sorell/whirling-electrons/README.md

PCB files and SW (mainly) for arduino
=====================================

Advent calendar
---------------
Pushing a button gives a random led from 4x6 matrix. Non-volatile state saving.

Bmp2arduino
-----------
Utility for converting a BMP to C code.

Infinity table
--------------
Lightshow for adressable RGB leds.

Tea timer
---------
Tea timer with I2C display and buzzer. Simple animations and a few songs, all in C.

Xmas lights
-----------
Like infinity table, different show.
