sorell/whirling-electrons/infinity-table-pcb/README.md

# PCB for the infinity-table project

Drive RGB leds with Arduino.

## Components

### Arduino Nano v2 or v3

### Barrel jack
Takes 8 ampers. Talk about oversizing.
https://www.digikey.fi/product-detail/en/cui-inc/PJ-063AH/CP-063AH-ND/2161208

## Future plans

Connect with Raspberry Pi to let the leds react with music.

### 74LVC8T245
Level shifter for future testing connection Arduino with Raspberry Pi
How to connect in [Adafruit page](https://www.adafruit.com/product/735)
