sorell/whirling-electrons/advent-calendar-rnd-sw/README.md

A simple advent calendar that randomizes one window when button is pressed. Remember displayed windows by writing state to eeprom.
