sorell/whirling-electrons/arduino-nano-breakout-1-pcb/README.md

# arduino-nano-breakout-1

A PCB design which houses an Arduino Nano, 5,5mm barrel jack, power source selection and output pin header for gpio.
