sorell/whirling-electrons/tea-timer-sw/README.md

# Tea timer

A tea timer with Arduino Nano, SSD1331 16-bit color OLED display, buzzer and two buttons.
