sorell/whirling-electrons/xmas-lights-sw/README.md

# XMAS LEDs

Wandering colors from WS2812 LED strips.
