sorell/whirling-electrons/kicad-ss-libs/FDN337N.models/ON_Semi_-_FDN337N.step

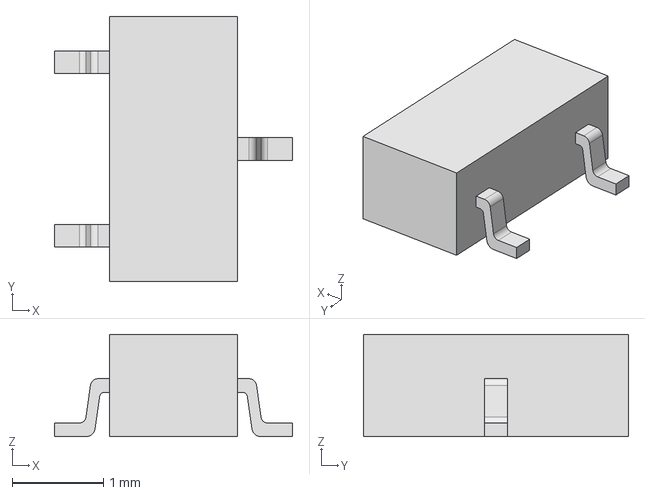
[picture p1: CAD file, 2022-10-30]
kicad-ss-libs/FDN337N.models/ON_Semi_-_FDN337N.step
2.61 x 2.90 x 1.12 mm
