sorell/whirling-electrons/advent-calendar-rnd-pcb/advent-calendar-rnd-sch.pdf

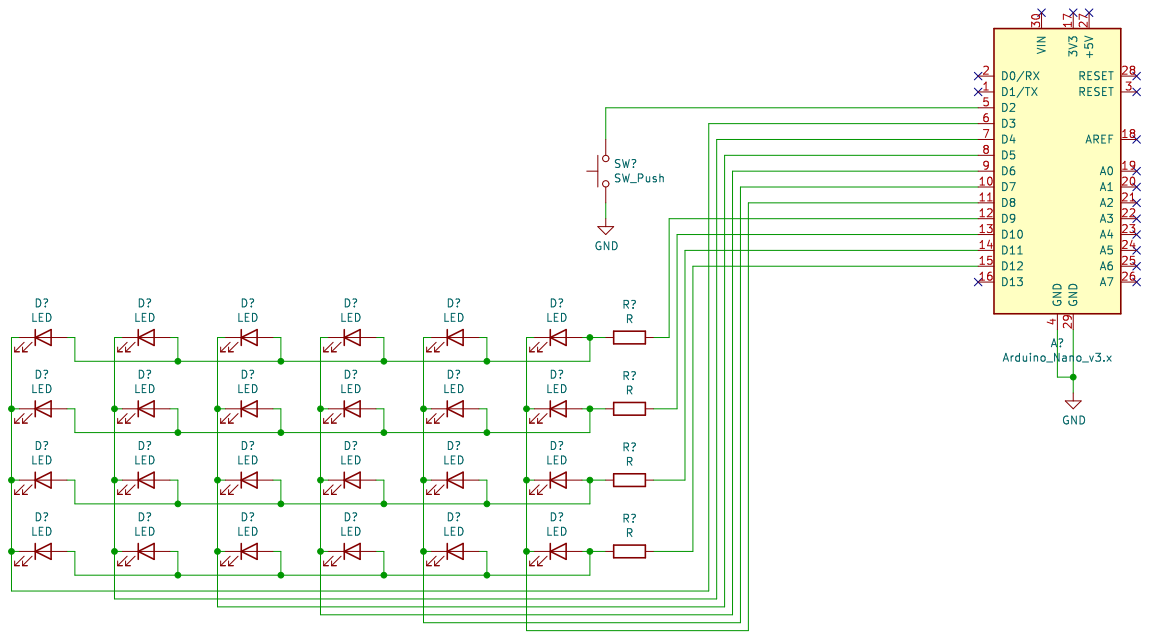
[picture p2: page 1]
