sorell/whirling-electrons/infinity-table-pcb/infinity-table-pcb.pdf

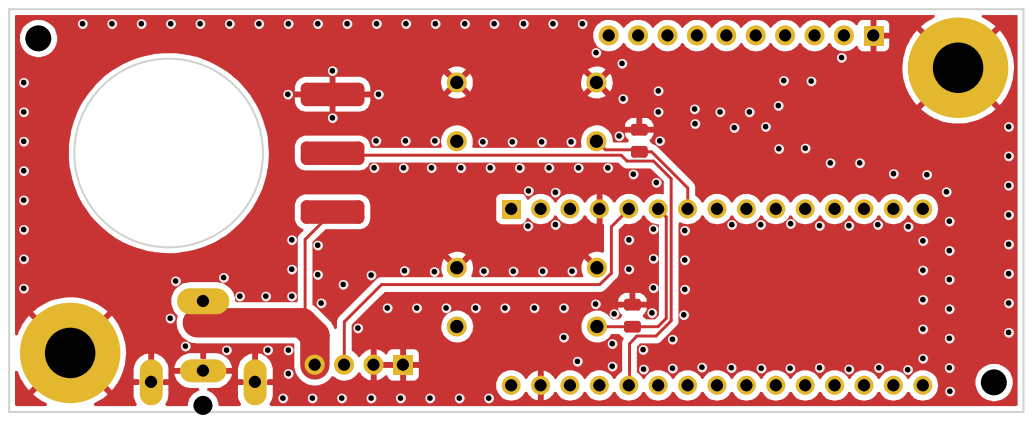
[picture p3: page 1]

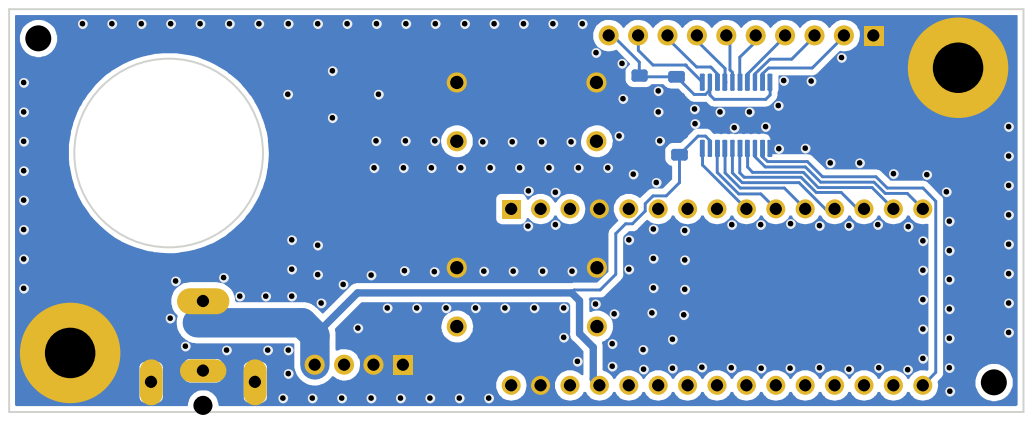
[picture p4: page 2]
