sorell/whirling-electrons/infinity-table-pcb/infinity-table-sch.pdf

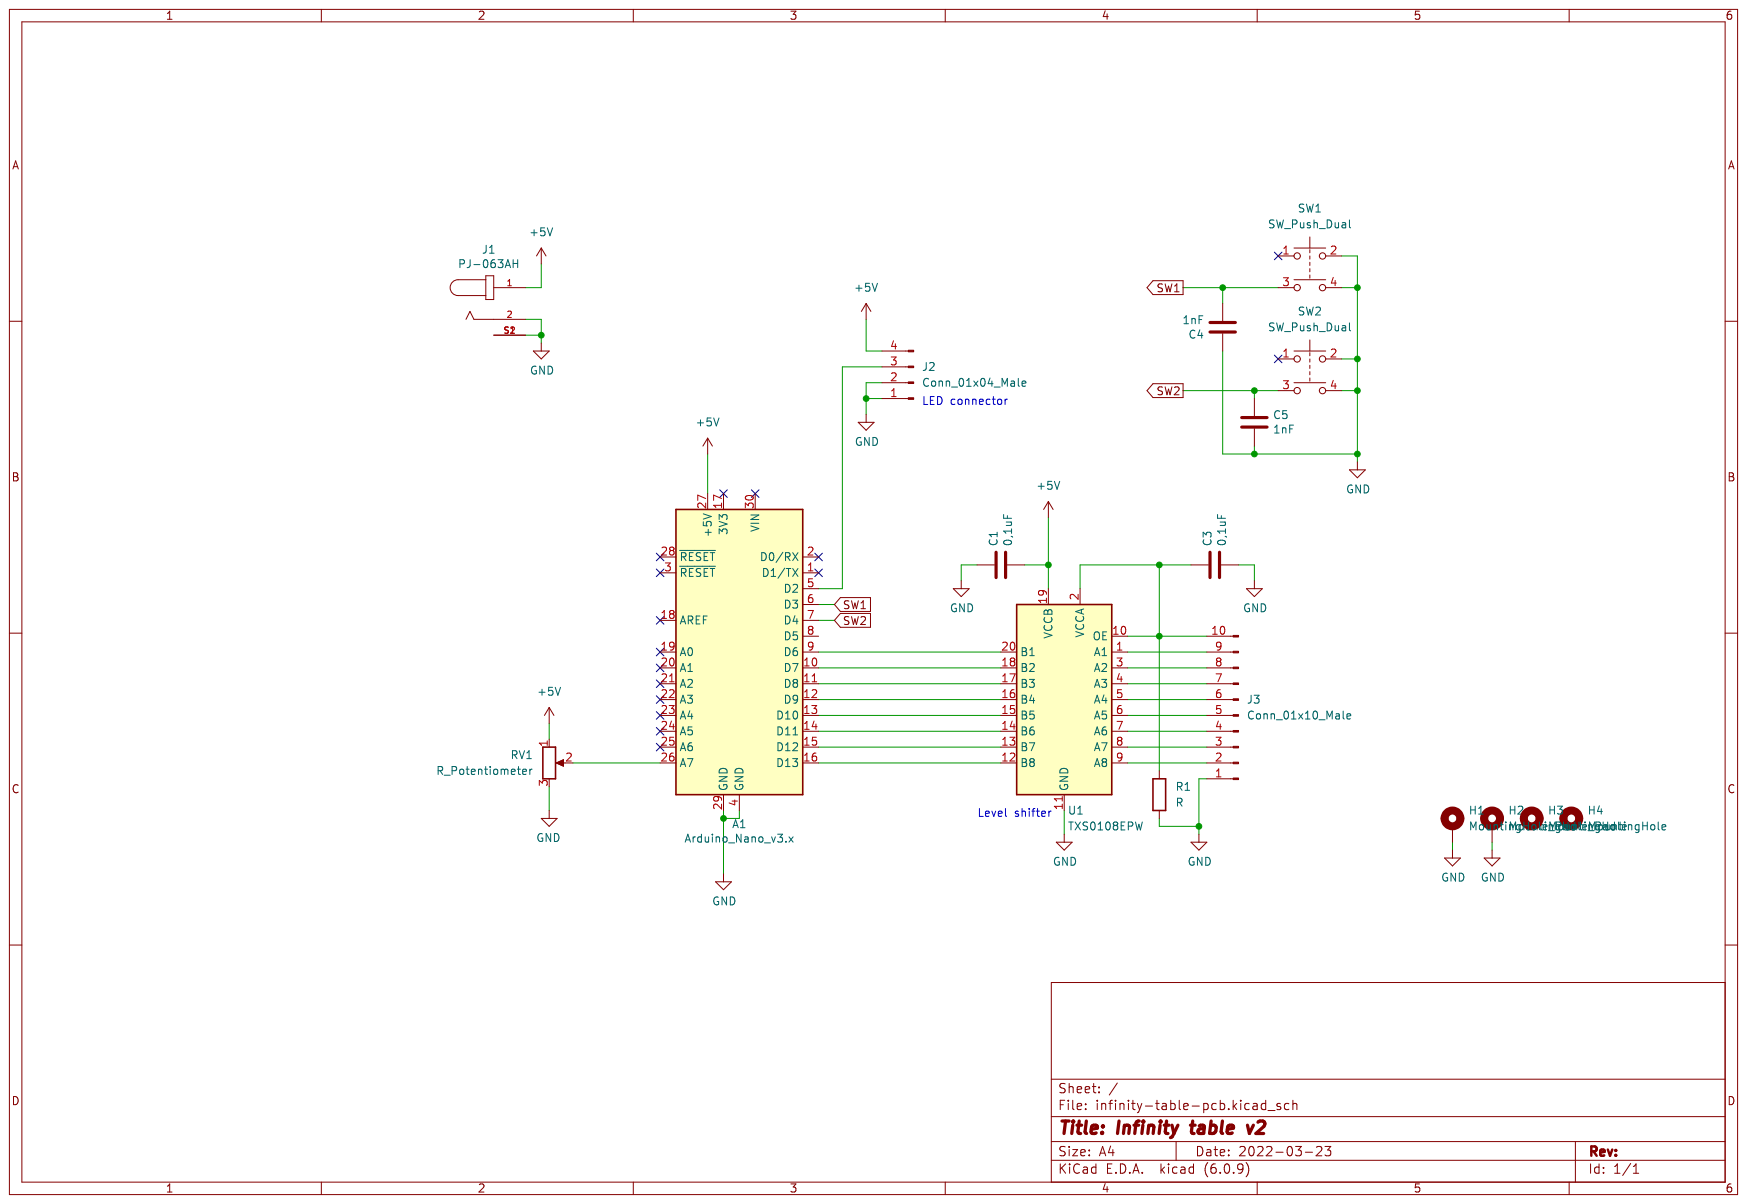
[picture p5: page 1]
