sorell/whirling-electrons/stairway-to-heaven-pcb/stairway-to-heaven-pcb.pdf

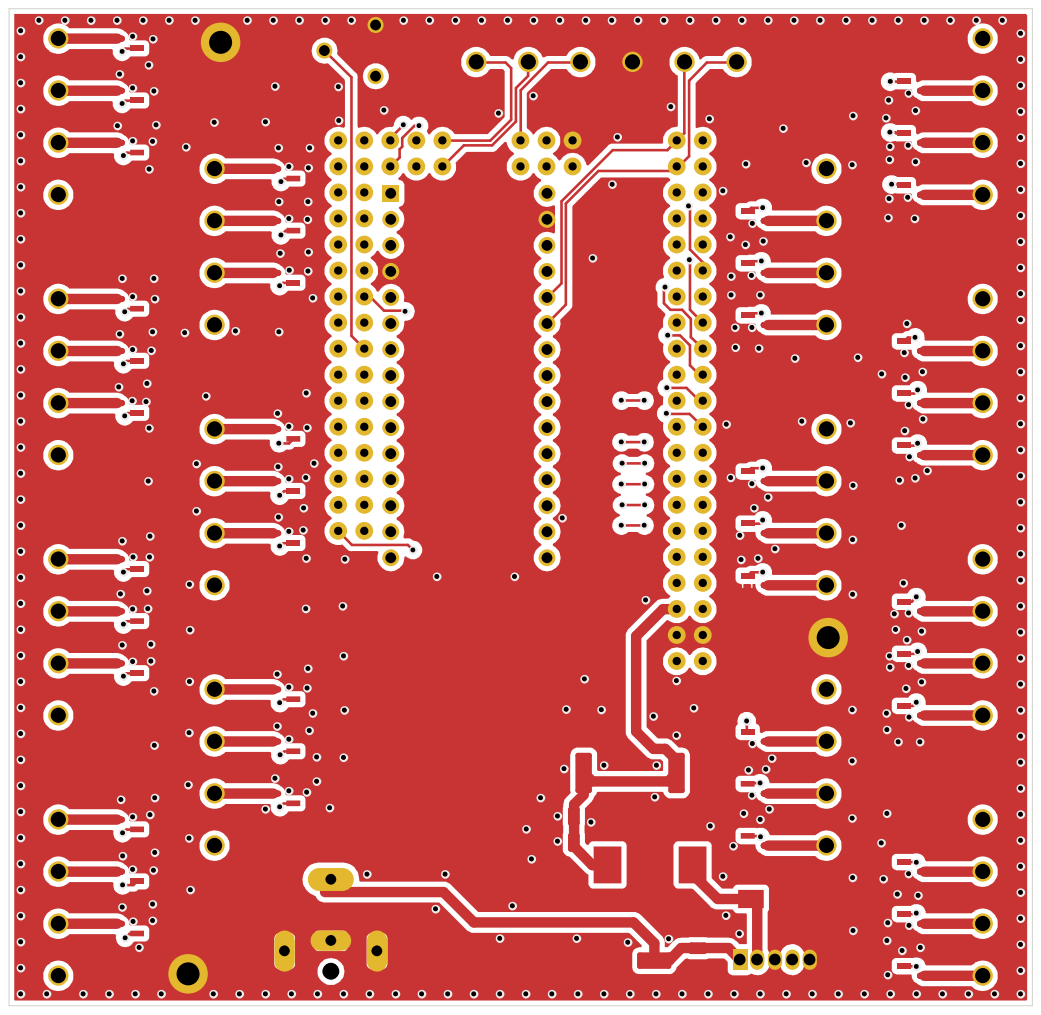
[picture p6: page 1]

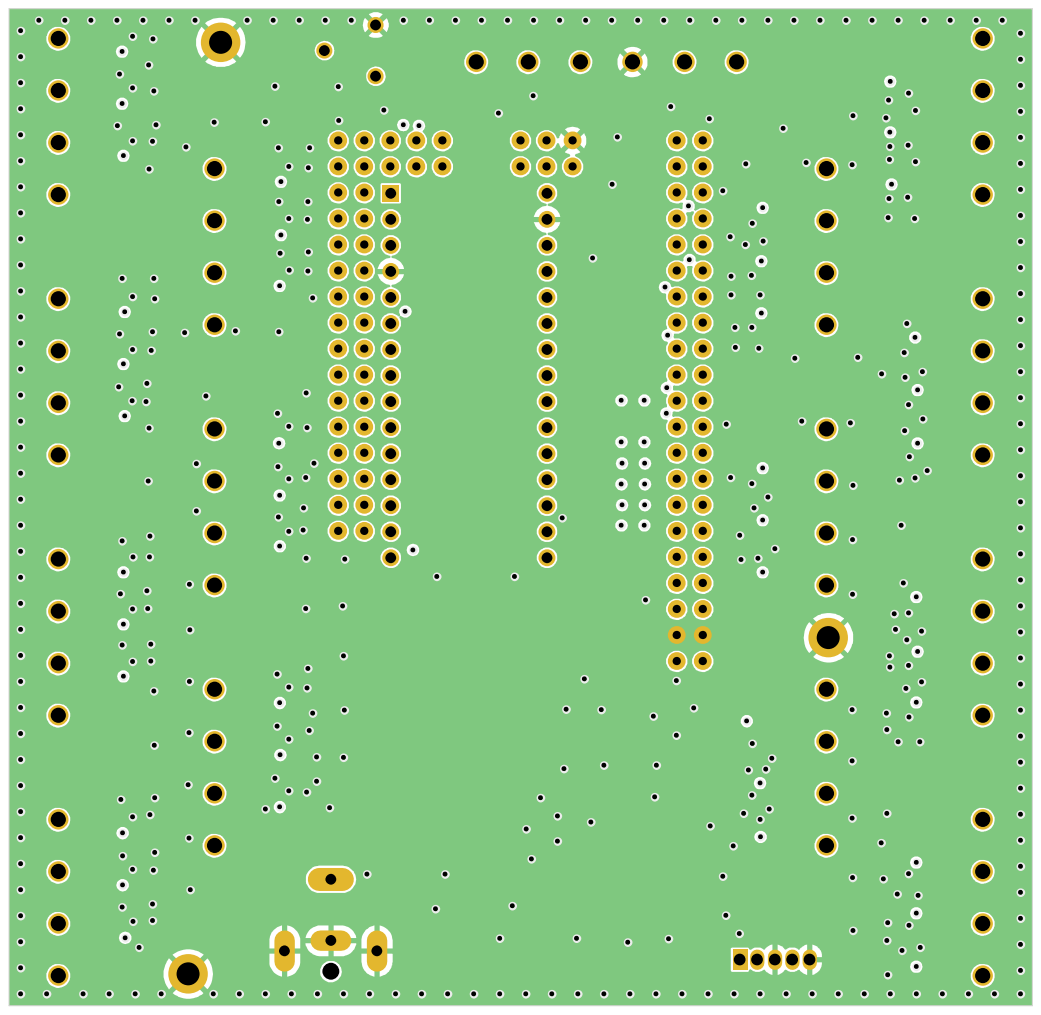
[picture p7: page 2]

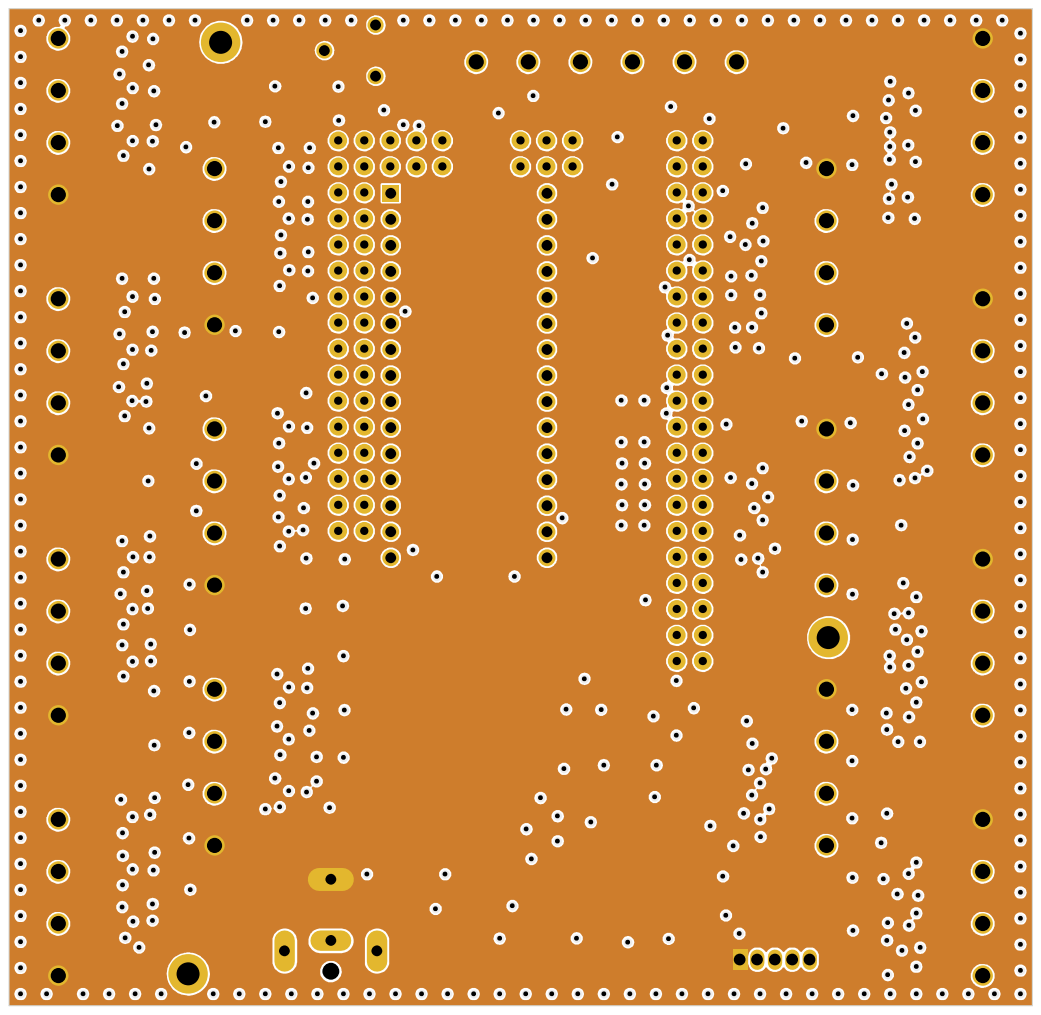
[picture p8: page 3]

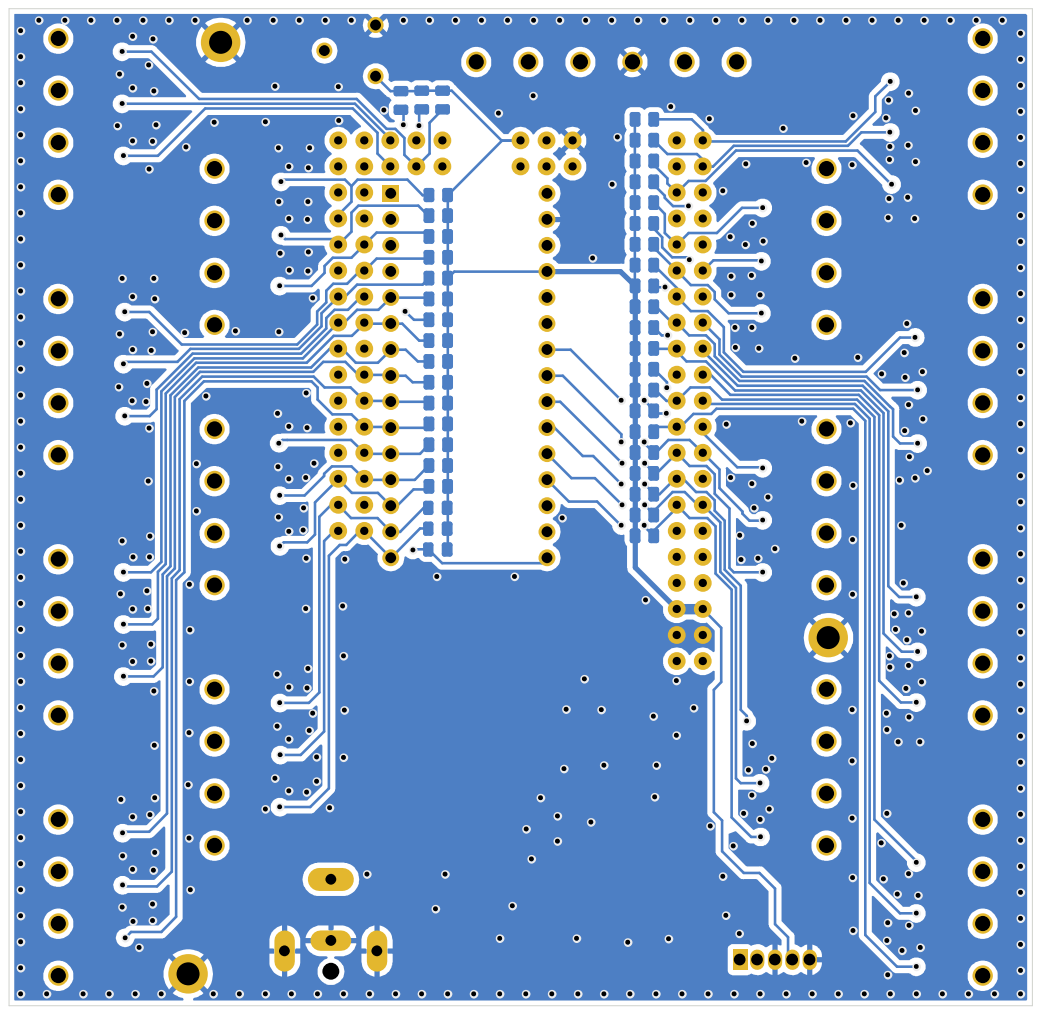
[picture p9: page 4]
