sorell/whirling-electrons/stairway-to-heaven-pcb/stairway-to-heaven-pcb.kicad_pcb

## KiCad design stairway-to-heaven-pcb/stairway-to-heaven-pcb.kicad_pcb (2022-10-30)

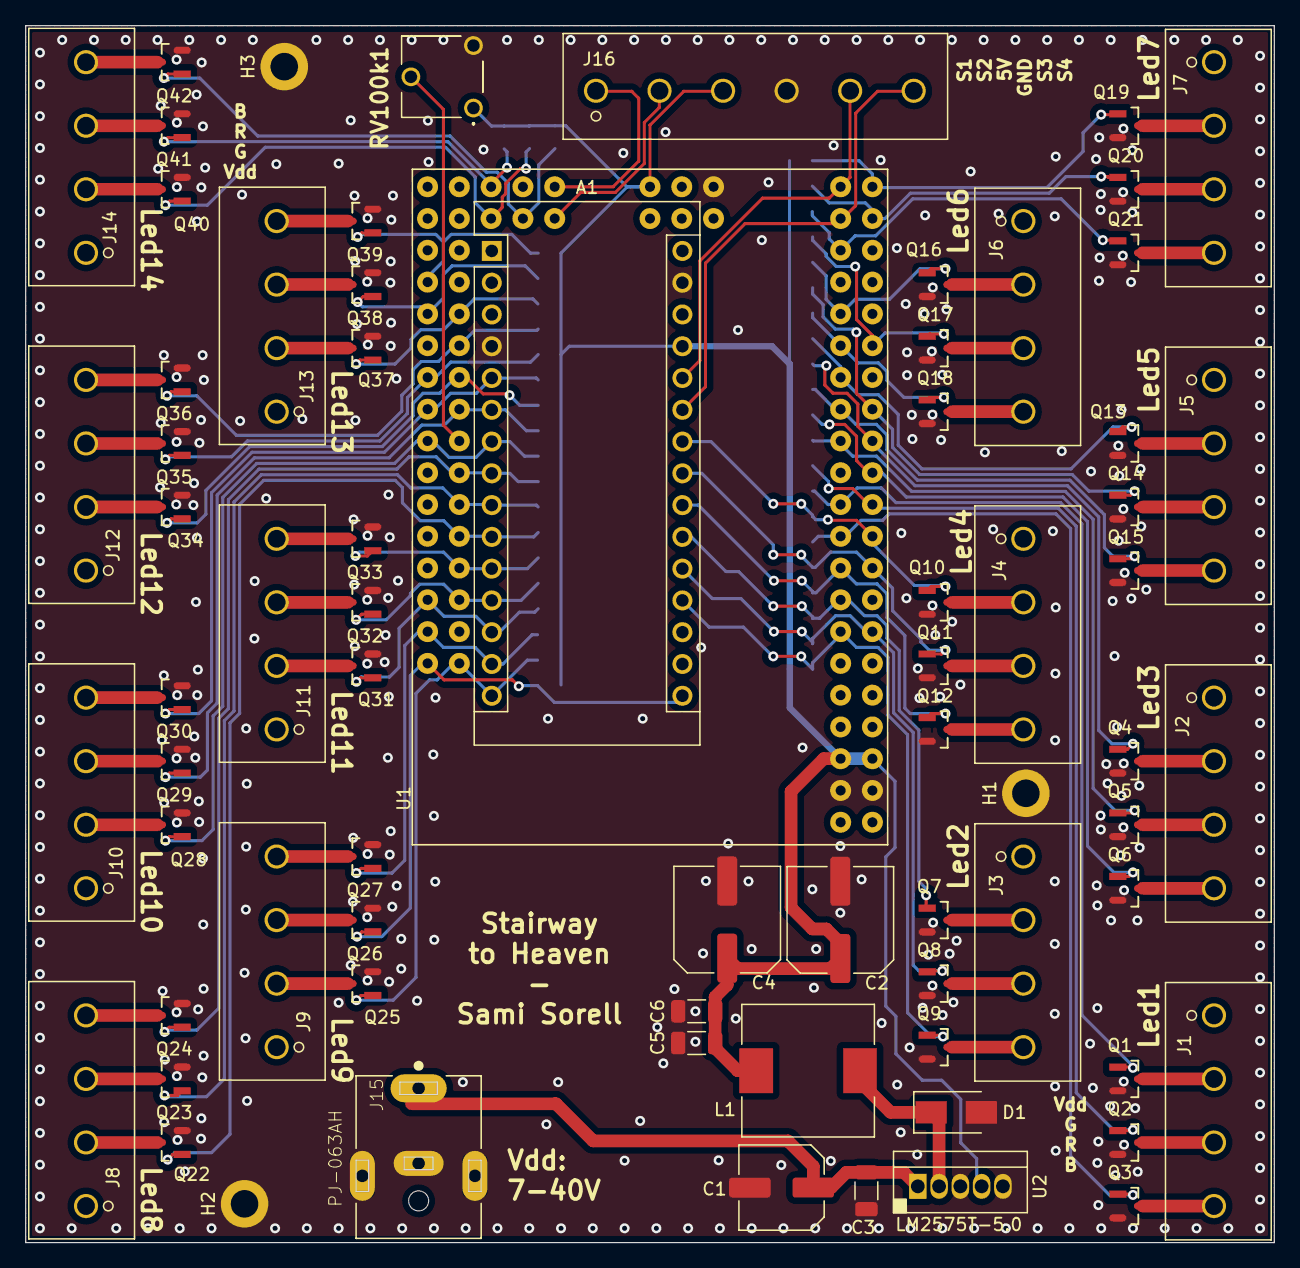
[picture p26: board stairway-to-heaven-pcb.kicad_pcb from above]

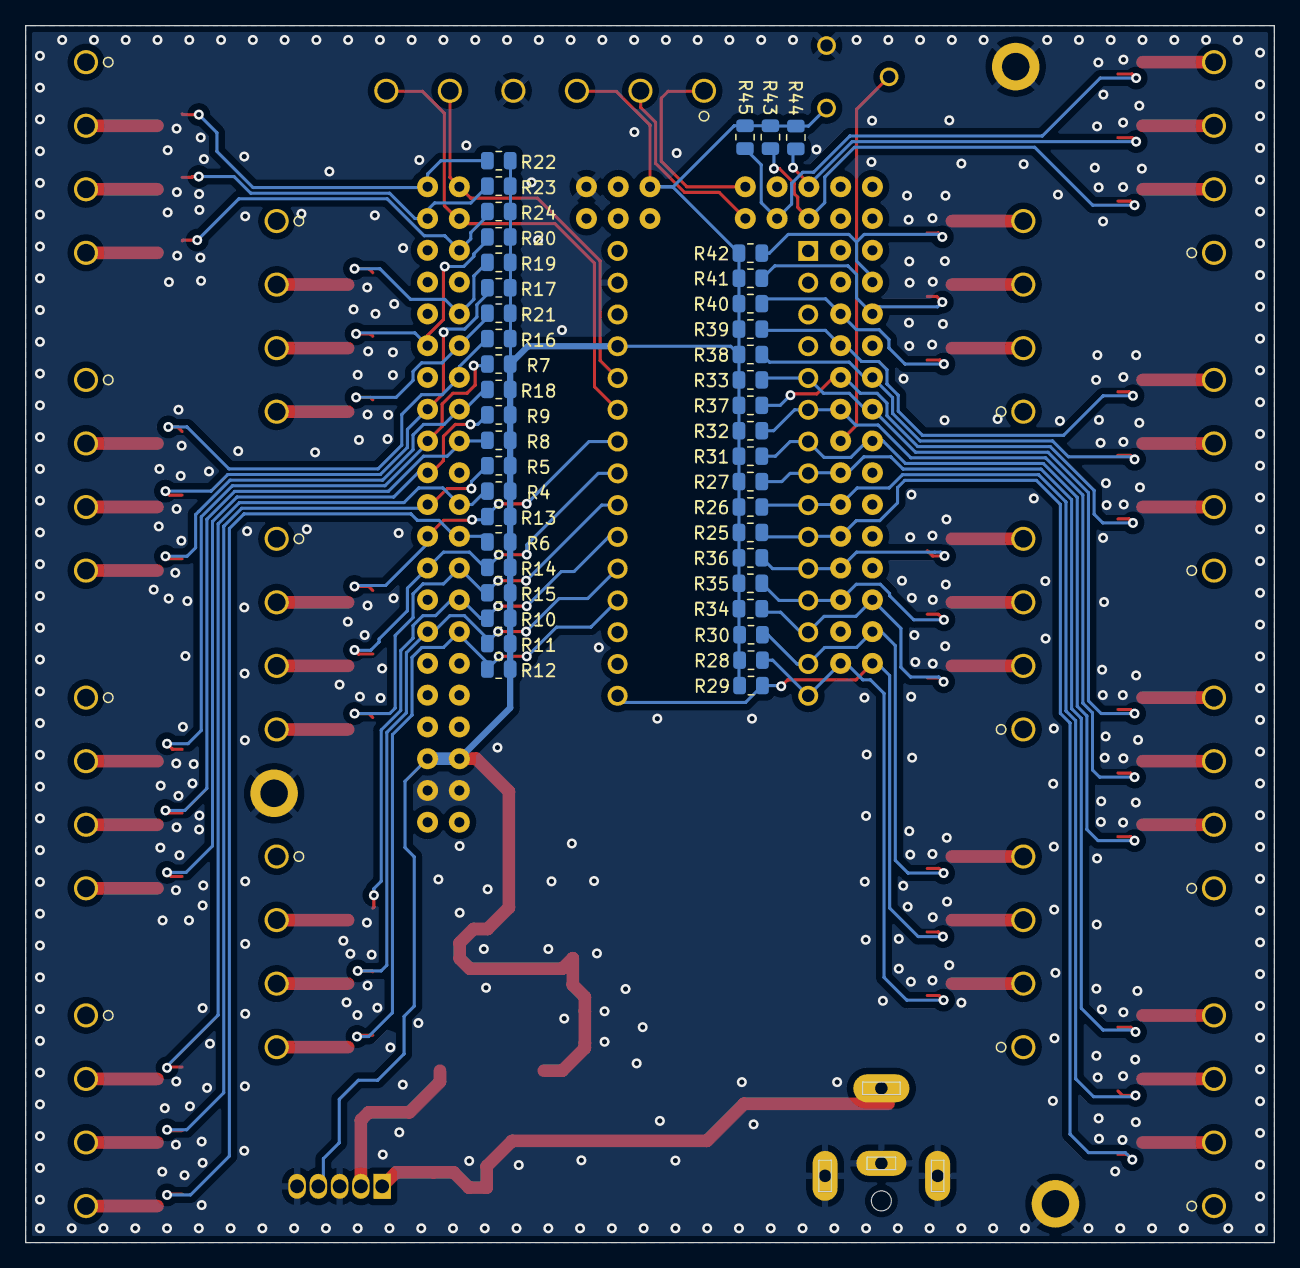
[picture p27: board stairway-to-heaven-pcb.kicad_pcb from below]

Board: 4 copper layers, 99.8 x 97.3 mm, 115 parts (42 on the bottom side), 93 nets.

Parts:
A1: Arduino_Nano_v2.x; Arduino_Nano
C1: 47uF; C_Elec_6.3x5.8
C2, C4: 100uF; C_Elec_8x6.2
C3, C5, C6: 10uF; C_1206_3216Metric
D1: DO-214AC; D_SMA
H1, H2, H3: MountingHole_Pad; MountingHole_2.2mm_M2_DIN965_Pad
J1, J2, J3, J4, J5, J6, J7, J8, J9, J10, J11, J12, J13, J14: Conn_01x04_Male; ScrewTerminal-5_08
J15: PJ-063AH; CUI_PJ-063AH
J16: Conn_01x06_Male; ScrewTerminal-5_08-6
L1: 100uH; L_10.4x10.4_H4.8
Q1, Q2, Q3, Q4, Q5, Q6, Q7, Q8, Q9, Q10, Q11, Q12, Q13, Q14, Q15, Q16, Q17, Q18, Q19, Q20, Q21, Q22, Q23, Q24, Q25, Q26, Q27, Q28, Q29, Q30, Q31, Q32, Q33, Q34, Q35, Q36, Q37, Q38, Q39, Q40, Q41, Q42: FDN337N; ON_Semi-527AG-01-12_2008-O-IPC_B
R4, R5, R6, R7, R8, R9, R10, R11, R12, R13, R14, R15, R16, R17, R18, R19, R20, R21, R22, R23, R24, R25, R26, R27, R28, R29, R30, R31, R32, R33, R34, R35, R36, R37, R38, R39, R40, R41, R42, R43, R44, R45: 50k; R_0805_2012Metric
RV100k1: R_Potentiometer_Trim; CA6V-NoMidHole
U1: MEGA_PRO_EMBED_CH340G_{slash}_ATMEGA2560; MEGA_PRO_EMBED_CH340G___ATMEGA2560
U2: LM2575T-5.0

Connections:
+5V: A1.27 (+5V), C2.1, C4.1, C5.1, C6.1, J16.3, L1.2, R4.1, R5.1, R6.1, R7.1, R8.1, R9.1, R10.1, R11.1, R12.1, R13.1, R14.1, R15.1, R16.1, R17.1, R18.1, R19.1, R20.1, R21.1, R22.1, R23.1, R24.1, R25.1, R26.1, R27.1, R28.1, R29.1, R30.1, R31.1, R32.1, R33.1, R34.1, R35.1, R36.1, R37.1, R38.1, R39.1, R40.1, R41.1, R42.1, R43.1, R44.1, R45.1, RV100k1.1, U1.5V_1 (5V), U1.5V_2 (5V), U1.5V_3 (5V), U2.4 (FB)
+12V: C1.1, C3.2, J1.1, J2.1, J3.1, J4.1, J5.1, J6.1, J7.1, J8.1, J9.1, J10.1, J11.1, J12.1, J13.1, J14.1, J15.1, U2.1 (VIN)
/LED1B_EN: Q3.1 (G), R6.2, U1.D8
/LED1G_EN: Q1.1 (G), R4.2, U1.D10
/LED1R_EN: Q2.1 (G), R5.2, U1.D11
/LED2B_EN: A1.19 (A0), Q9.1 (G), R12.2, U1.D2
/LED2G_EN: A1.21 (A2), Q7.1 (G), R10.2, U1.D4
/LED2R_EN: A1.20 (A1), Q8.1 (G), R11.2, U1.D3
/LED3B_EN: Q6.1 (G), R9.2, U1.D13
/LED3G_EN: Q4.1 (G), R7.2, U1.D15
/LED3R_EN: Q5.1 (G), R8.2, U1.D14
/LED4B_EN: A1.22 (A3), Q12.1 (G), R15.2, U1.D6
/LED4G_EN: A1.24 (A5), Q10.1 (G), R13.2, U1.D9
/LED4R_EN: A1.23 (A4), Q11.1 (G), R14.2, U1.D7
/LED5B_EN: Q15.1 (G), R18.2, U1.D16
/LED5G_EN: Q13.1 (G), R16.2, U1.D18
/LED5R_EN: Q14.1 (G), R17.2, U1.D17
/LED6B_EN: Q18.1 (G), R21.2, U1.D20
/LED6G_EN: Q16.1 (G), R19.2, U1.D22
/LED6R_EN: Q17.1 (G), R20.2, U1.D21
/LED7B_EN: Q21.1 (G), R24.2, U1.D26
/LED7G_EN: Q19.1 (G), R22.2, U1.D31
/LED7R_EN: Q20.1 (G), R23.2, U1.D29
/LED8B_EN: A1.8 (D5), Q24.1 (G), R27.2, U1.A13
/LED8G_EN: A1.10 (D7), Q22.1 (G), R25.2, U1.A9
/LED8R_EN: A1.9 (D6), Q23.1 (G), R26.2, U1.A11
/LED9B_EN: A1.14 (D11), Q27.1 (G), R30.2, U1.A2
/LED9G_EN: A1.15 (D12), Q25.1 (G), R28.2, U1.A1
/LED9R_EN: A1.16 (D13), Q26.1 (G), R29.2, U1.A0
/LED10B_EN: A1.5 (D2), Q30.1 (G), R33.2, U1.D32
/LED10G_EN: A1.7 (D4), Q28.1 (G), R31.2, U1.A14
/LED10R_EN: A1.6 (D3), Q29.1 (G), R32.2, U1.D33
/LED11B_EN: A1.11 (D8), Q33.1 (G), R36.2, U1.A7
/LED11G_EN: A1.13 (D10), Q31.1 (G), R34.2, U1.A4
/LED11R_EN: A1.12 (D9), Q32.1 (G), R35.2, U1.A5
/LED12B_EN: Q36.1 (G), R39.2, U1.D37
/LED12G_EN: Q34.1 (G), R37.2, U1.D35
/LED12R_EN: Q35.1 (G), R38.2, U1.D34
/LED13B_EN: Q39.1 (G), R42.2, U1.D40
/LED13G_EN: Q37.1 (G), R40.2, U1.D39
/LED13R_EN: Q38.1 (G), R41.2, U1.D38
/LED14B_EN: Q42.1 (G), R45.2, U1.D51
/LED14G_EN: Q40.1 (G), R43.2, U1.D49
/LED14R_EN: Q41.1 (G), R44.2, U1.D48
/POT1: RV100k1.2, U1.A15
/SENSOR1: J16.1, U1.D52
/SENSOR2: J16.2, U1.D53
/SENSOR3: A1.26 (A7), J16.5, U1.D30
/SENSOR4: A1.25 (A6), J16.6, U1.D28
GND: A1.4 (GND), A1.29 (GND), C1.2, C2.2, C3.1, C4.2, C5.2, C6.2, D1.2 (A), H1.1, H2.1, H3.1, J15.2, J15.S1 (SHIELD), J15.S2 (SHIELD), J16.4, Q1.3 (S), Q2.3 (S), Q3.3 (S), Q4.3 (S), Q5.3 (S), Q6.3 (S), Q7.3 (S), Q8.3 (S), Q9.3 (S), Q10.3 (S), Q11.3 (S), Q12.3 (S), Q13.3 (S), Q14.3 (S), Q15.3 (S), Q16.3 (S), Q17.3 (S), Q18.3 (S), Q19.3 (S), Q20.3 (S), Q21.3 (S), Q22.3 (S), Q23.3 (S), Q24.3 (S), Q25.3 (S), Q26.3 (S), Q27.3 (S), Q28.3 (S), Q29.3 (S), Q30.3 (S), Q31.3 (S), Q32.3 (S), Q33.3 (S), Q34.3 (S), Q35.3 (S), Q36.3 (S), Q37.3 (S), Q38.3 (S), Q39.3 (S), Q40.3 (S), Q41.3 (S), Q42.3 (S), RV100k1.3, U1.GND_1 (GND), U1.GND_2 (GND), U1.GND_3 (GND), U2.3 (GND), U2.5 (ON_OFF_N)
unnamed: D1.1 (K), L1.1, U2.2 (OUT)
unnamed: J1.2, Q1.2 (D)
unnamed: J1.3, Q2.2 (D)
unnamed: J1.4, Q3.2 (D)
unnamed: J2.2, Q4.2 (D)
unnamed: J2.3, Q5.2 (D)
unnamed: J2.4, Q6.2 (D)
unnamed: J3.2, Q7.2 (D)
unnamed: J3.3, Q8.2 (D)
unnamed: J3.4, Q9.2 (D)
unnamed: J4.2, Q10.2 (D)
unnamed: J4.3, Q11.2 (D)
unnamed: J4.4, Q12.2 (D)
unnamed: J5.2, Q13.2 (D)
unnamed: J5.3, Q14.2 (D)
unnamed: J5.4, Q15.2 (D)
unnamed: J6.2, Q16.2 (D)
unnamed: J6.3, Q17.2 (D)
unnamed: J6.4, Q18.2 (D)
unnamed: J7.2, Q19.2 (D)
unnamed: J7.3, Q20.2 (D)
unnamed: J7.4, Q21.2 (D)
unnamed: J8.2, Q22.2 (D)
unnamed: J8.3, Q23.2 (D)
unnamed: J8.4, Q24.2 (D)
unnamed: J9.2, Q25.2 (D)
unnamed: J9.3, Q26.2 (D)
unnamed: J9.4, Q27.2 (D)
unnamed: J10.2, Q28.2 (D)
unnamed: J10.3, Q29.2 (D)
unnamed: J10.4, Q30.2 (D)
unnamed: J11.2, Q31.2 (D)
unnamed: J11.3, Q32.2 (D)
unnamed: J11.4, Q33.2 (D)
unnamed: J12.2, Q34.2 (D)
unnamed: J12.3, Q35.2 (D)
unnamed: J12.4, Q36.2 (D)
unnamed: J13.2, Q37.2 (D)
unnamed: J13.3, Q38.2 (D)
unnamed: J13.4, Q39.2 (D)
unnamed: J14.2, Q40.2 (D)
unnamed: J14.3, Q41.2 (D)
unnamed: J14.4, Q42.2 (D)
