sorell/whirling-electrons/infinity-table-pcb/infinity-table-pcb.kicad_pcb

## KiCad design infinity-table-pcb/infinity-table-pcb.kicad_pcb (2022-03-23)

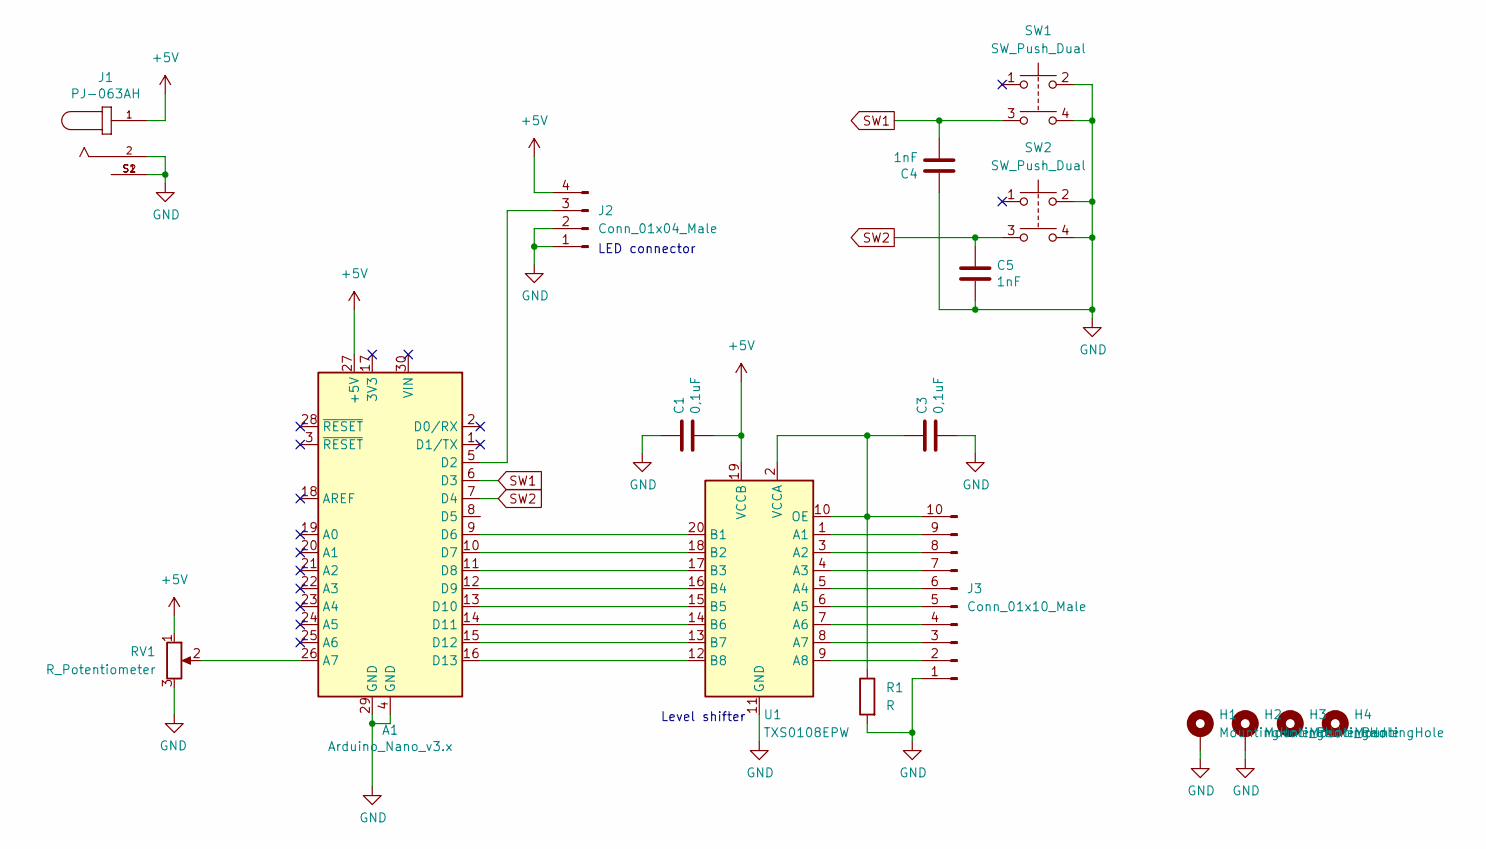
[picture p28: schematic infinity-table-pcb.kicad_sch, Infinity table v2]

Parts:
A1: Arduino_Nano_v3.x; Arduino_Nano
C1, C3: 0,1uF; C_0805_2012Metric
C4, C5: 1nF; C_0805_2012Metric
H1, H2: MountingHole_Pad; MountingHole_4.3mm_M4_Pad
H3, H4: MountingHole; MountingHole_2.2mm_M2
J1: PJ-063AH; CUI_PJ-063AH
J2: Conn_01x04_Male; PinHeader_1x04_P2.54mm_Vertical
J3: Conn_01x10_Male; PinHeader_1x10_P2.54mm_Vertical
R1: R; R_0805_2012Metric
RV1: R_Potentiometer; Potentiometer Pads
SW1, SW2: SW_Push_Dual; Push Button 12x12mm
U1: TXS0108EPW; TSSOP-20_4.4x6.5mm_P0.65mm

Connections:
+5V: A1.27 (+5V), C1.2, J1.1, J2.4, RV1.1, U1.19 (VCCB)
GND: A1.4 (GND), A1.29 (GND), C1.1, C3.2, C4.1, C5.2, H1.1, H2.1, J1.2, J1.S1 (SHIELD), J1.S2 (SHIELD), J2.1, J2.2, J3.1, R1.2, RV1.3, SW1.2, SW1.4, SW2.2, SW2.4, U1.11 (GND)
unnamed: A1.5 (D2), J2.3
unnamed: A1.9 (D6), U1.20 (B1)
unnamed: A1.10 (D7), U1.18 (B2)
unnamed: A1.11 (D8), U1.17 (B3)
unnamed: A1.12 (D9), U1.16 (B4)
unnamed: A1.13 (D10), U1.15 (B5)
unnamed: A1.14 (D11), U1.14 (B6)
unnamed: A1.15 (D12), U1.13 (B7)
unnamed: A1.16 (D13), U1.12 (B8)
unnamed: A1.26 (A7), RV1.2
unnamed: C3.1, J3.10, R1.1, U1.2 (VCCA), U1.10 (OE)
unnamed: J3.2, U1.9 (A8)
unnamed: J3.3, U1.8 (A7)
unnamed: J3.4, U1.7 (A6)
unnamed: J3.5, U1.6 (A5)
unnamed: J3.6, U1.5 (A4)
unnamed: J3.7, U1.4 (A3)
unnamed: J3.8, U1.3 (A2)
unnamed: J3.9, U1.1 (A1)
SW1: A1.6 (D3), C4.2, SW1.3
SW2: A1.7 (D4), C5.1, SW2.3

Notes on the sheet:
LED connector
Level shifter

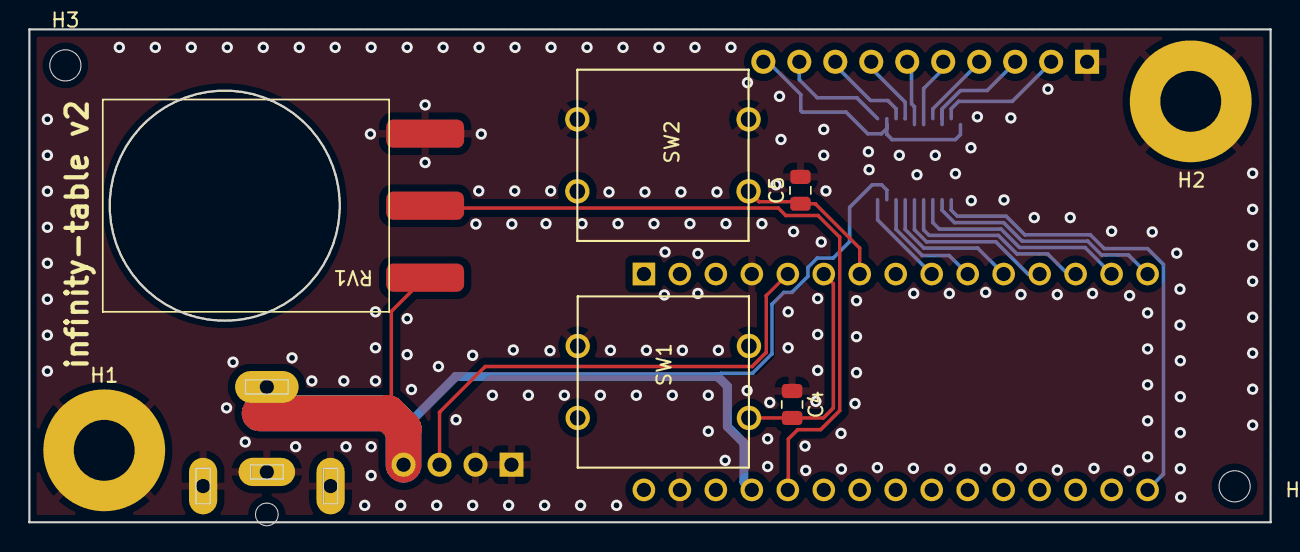
[picture p29: board infinity-table-pcb.kicad_pcb from above]

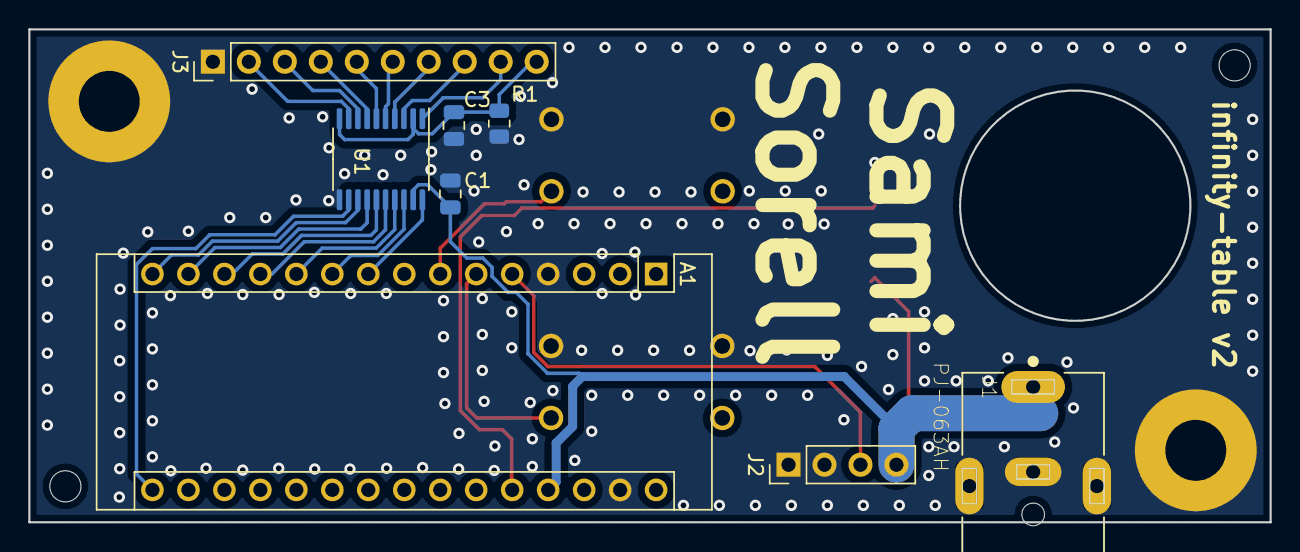
[picture p30: board infinity-table-pcb.kicad_pcb from below]

Board: 2 copper layers, 87.6 x 34.8 mm, 17 parts (8 on the bottom side), 23 nets.
