sorell/whirling-electrons/tea-timer-pcb/pcb-tea-timer.kicad_pcb

## KiCad design tea-timer-pcb/pcb-tea-timer.kicad_pcb (2019-09-20)

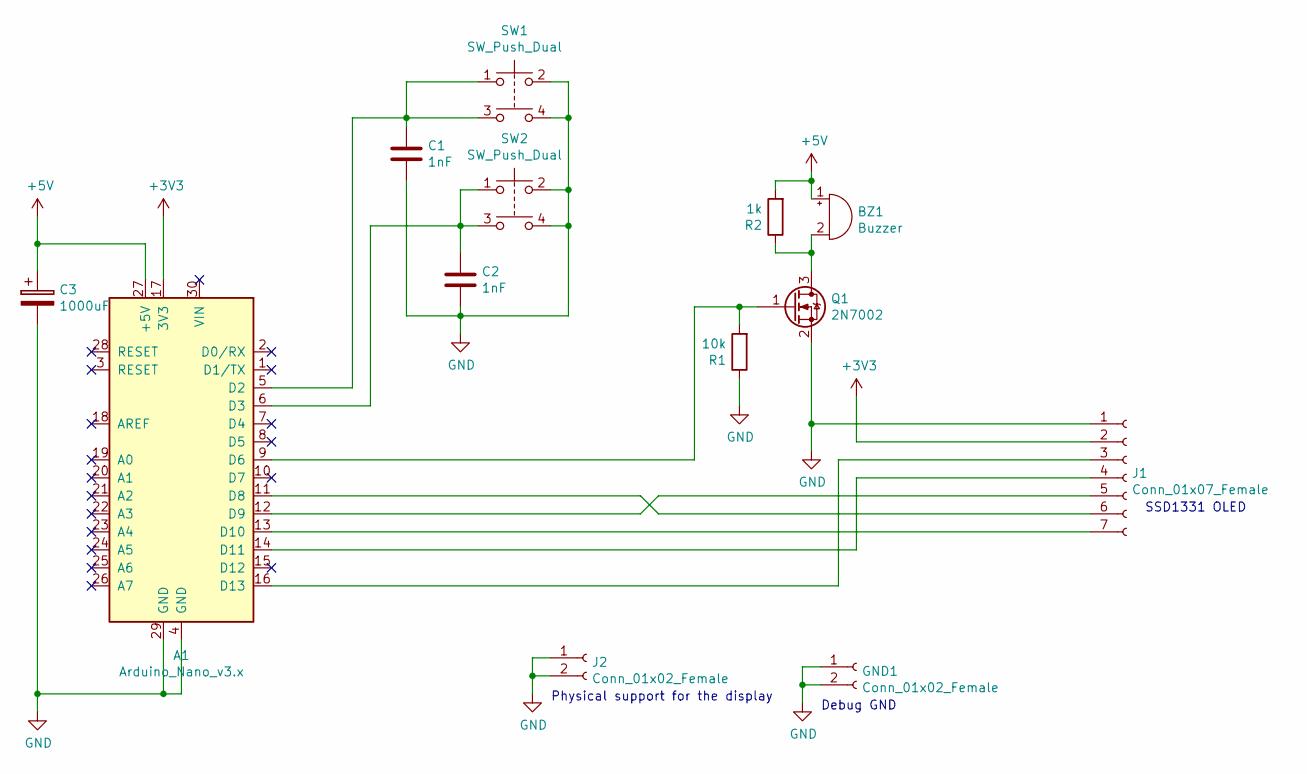
[picture p34: schematic pcb-tea-timer.sch]

Parts:
A1: Arduino_Nano_v3.x; Arduino_Nano
BZ1: Buzzer; Round Piezo 1
C1, C2: 1nF; C_0805_2012Metric_Pad1.15x1.40mm_HandSolder
C3: 1000uF; CP_Radial_D7.5mm_P2.50mm
GND1: Conn_01x02_Female; PinHeader_1x02_P2.54mm_Vertical
J1: Conn_01x07_Female; PinHeader_1x07_P2.54mm_Vertical
J2: Conn_01x02_Female; PinHeader_1x02_P2.54mm_Vertical
Q1: 2N7002; SOT-23
R1: 10k; R_0805_2012Metric_Pad1.15x1.40mm_HandSolder
R2: 1k; R_0805_2012Metric_Pad1.15x1.40mm_HandSolder
SW1, SW2: SW_Push_Dual; Push Button 12x12mm

Connections:
+3V3: A1.17 (3V3), J1.2
+5V: A1.27 (+5V), BZ1.1 (-), C3.1, R2.2
GND: A1.4 (GND), A1.29 (GND), C1.2, C2.2, C3.2, GND1.1, GND1.2, J1.1, J2.1, J2.2, Q1.2 (S), R1.1, SW1.2, SW1.4, SW2.2, SW2.4
unnamed: A1.5 (D2), C1.1, SW1.1, SW1.3
unnamed: A1.6 (D3), C2.1, SW2.1, SW2.3
unnamed: A1.9 (D6), Q1.1 (G), R1.2
unnamed: A1.11 (D8), J1.6
unnamed: A1.12 (D9), J1.5
unnamed: A1.13 (D10), J1.7
unnamed: A1.14 (D11), J1.4
unnamed: A1.16 (D13), J1.3
unnamed: BZ1.2 (+), Q1.3 (D), R2.1

Notes on the sheet:
SSD1331 OLED
Physical support for the display
Debug GND

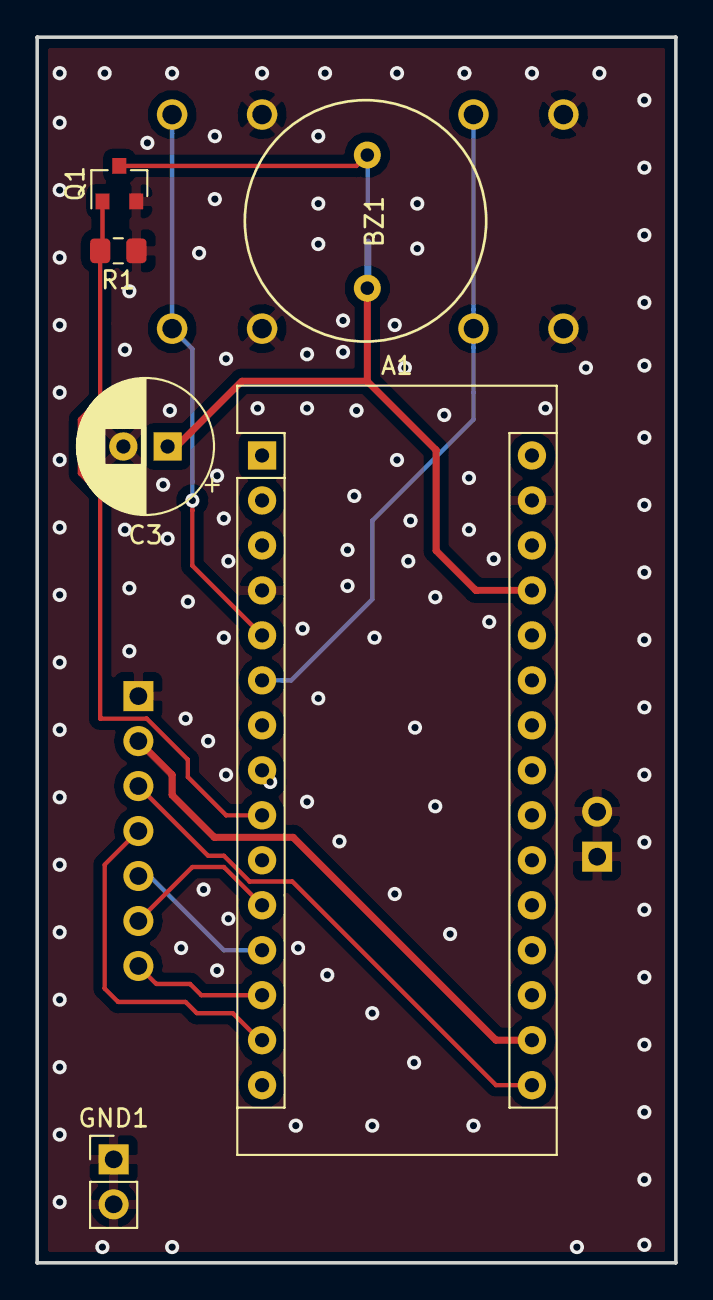
[picture p35: board pcb-tea-timer.kicad_pcb from above]

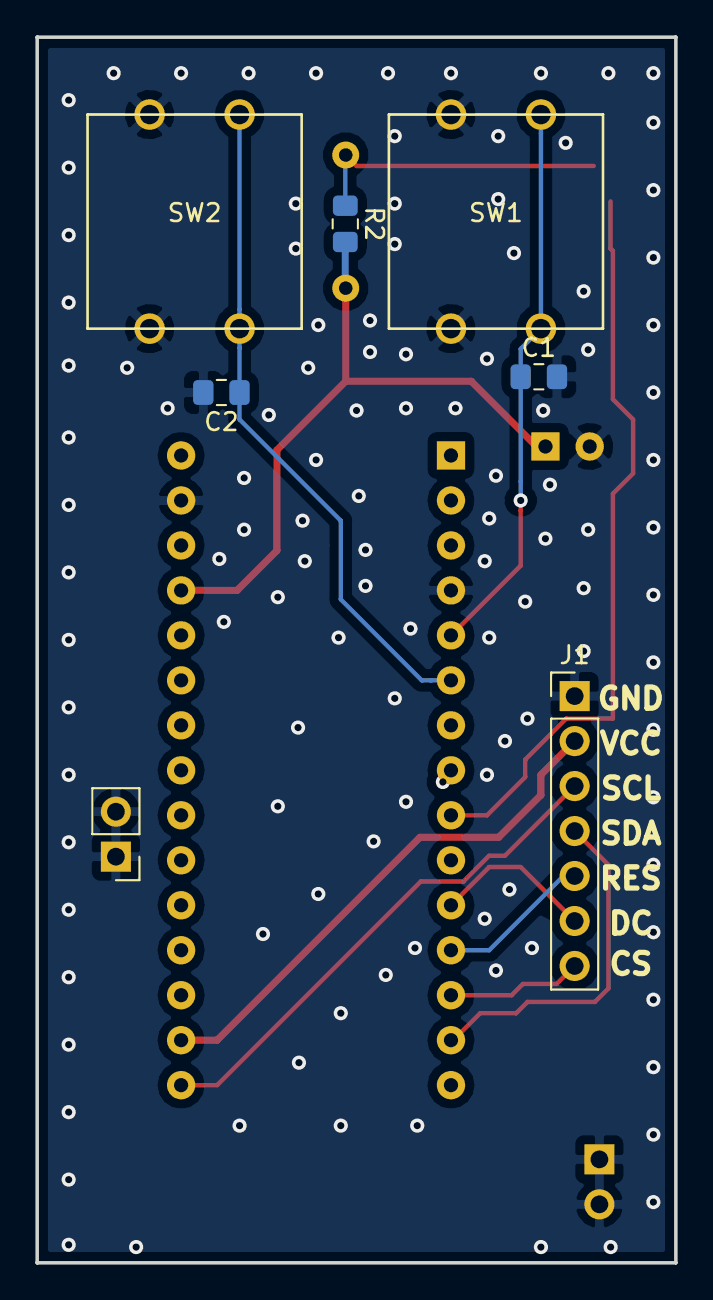
[picture p36: board pcb-tea-timer.kicad_pcb from below]

Board: 2 copper layers, 36.1 x 69.2 mm, 13 parts (7 on the bottom side), 12 nets.
