sorell/whirling-electrons/arduino-nano-breakout-1-pcb/arduino-nano-breakout-1.kicad_pcb

## KiCad design arduino-nano-breakout-1-pcb/arduino-nano-breakout-1.kicad_pcb (2018-12-11)

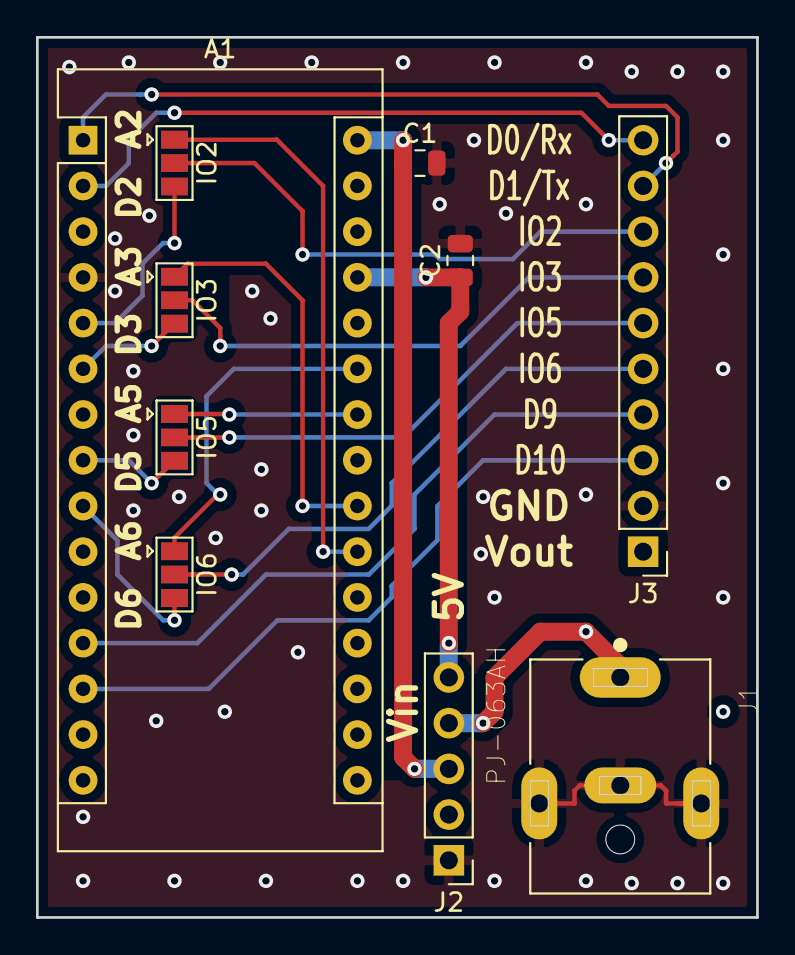
[picture p37: board arduino-nano-breakout-1.kicad_pcb from above]

Board: 2 copper layers, 40.0 x 48.9 mm, 10 parts (0 on the bottom side), 20 nets.

Parts:
A1: Arduino_Nano_v3.x; Arduino_Nano
C1, C2: 100nF; C_0805_2012Metric
IO2, IO3, IO5, IO6: SolderJumper_3_Open; SolderJumper-3_P1.3mm_Open_Pad1.0x1.5mm
J1: PJ-063AH; CUI_PJ-063AH-1
J2: Conn_01x05_Male; PinHeader_1x05_P2.54mm_Vertical
J3: Conn_01x10_Male; PinHeader_1x10_P2.54mm_Vertical

Connections:
D0: A1.2, J3.10
D1: A1.1, J3.9
D2: A1.5, IO2.3
D3: A1.6, IO3.3
D5: A1.8, IO5.3
D6: A1.9, IO6.3
D9: A1.12, J3.4
D10: A1.13, J3.3
GND: A1.4, A1.29, C1.2, C2.2, J1.2, J1.S1, J1.S2, J2.1, J3.2
unnamed: A1.21, IO2.1
unnamed: A1.22, IO3.1
unnamed: A1.24, IO5.1
unnamed: A1.25, IO6.1
unnamed: A1.27, C2.1, J2.5
unnamed: A1.30, C1.1, J2.3
unnamed: IO2.2, J3.8
unnamed: IO3.2, J3.7
unnamed: IO5.2, J3.6
unnamed: IO6.2, J3.5
unnamed: J1.1, J2.4, J3.1
