sorell/whirling-electrons/test-arduino-er-erm029/Examples_ER-EPM029-1Y/imagedata.cpp

/***************************************************
//Web: http://www.buydisplay.com
EastRising Technology Co.,LTD
****************************************************/

#include "imagedata.h"
#include <avr/pgmspace.h>

const unsigned char IMAGE_BLACK[4736] PROGMEM = {/* 0X10,0X01,0X00,0X80,0X01,0X28, */
0XFF,0XFF,0XFF,0XF0,0X00,0X00,0X00,0X00,0X00,0X00,0X00,0X00,0X00,0X00,0X00,0X00,
0XFF,0XFF,0XFF,0XF0,0X00,0X00,0X00,0X00,0X00,0X00,0X00,0X00,0X00,0X00,0X00,0X00,
0XFF,0XFF,0XFF,0XF0,0X00,0X00,0X00,0X00,0X00,0X00,0X00,0X00,0X00,0X00,0X00,0X00,
0XFF,0XFF,0XFF,0XF0,0X00,0X00,0X00,0X00,0X00,0X00,0X00,0X00,0X00,0X00,0X00,0X00,
0XFF,0XFF,0XFB,0XF0,0X00,0X00,0X00,0X00,0X00,0X00,0X00,0X00,0X00,0X00,0X00,0X00,
0XFF,0XFF,0XE3,0XF0,0X00,0X00,0X00,0X00,0X00,0X00,0X00,0X00,0X00,0X00,0X00,0X00,
0XFF,0XFF,0X83,0XF0,0X00,0X00,0X00,0X00,0X00,0X00,0X00,0X00,0X01,0XE0,0X00,0X00,
0XFF,0XFE,0X07,0XF0,0X00,0X00,0X00,0X02,0X00,0X00,0X00,0X00,0X03,0XF0,0X00,0X00,
0XFF,0X80,0X1F,0XF0,0X07,0XFF,0X00,0X1E,0X1F,0XFC,0X00,0X00,0X0F,0XFC,0X00,0X00,
0XFF,0X80,0X7F,0XF0,0X07,0XFF,0X00,0XFC,0X1F,0XFC,0X00,0X00,0X3F,0XFF,0X00,0X00,
0XFF,0X80,0X1F,0XF0,0X07,0XFF,0X07,0XE0,0X1F,0XFC,0X00,0X00,0X7F,0XFF,0X00,0X00,
0XFF,0XFE,0X07,0XF0,0X06,0X03,0X0F,0X00,0X00,0XC0,0X00,0X00,0XFF,0XFF,0XC0,0X00,
0XFF,0XFF,0X83,0XF0,0X06,0X03,0X0F,0X00,0X00,0XC0,0X00,0X01,0XFF,0XFF,0XE0,0X00,
0XFF,0XFF,0XE3,0XF0,0X06,0X03,0X07,0XE0,0X00,0XC0,0X00,0X01,0XFF,0XFF,0XF0,0X00,
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
0XF3,0X60,0X82,0X89,0X26,0X00,0X00,0X00,0X00,0X00,0X00,0X00,0X00,0X00,0X00,0X07,
0XFF,0XC0,0X98,0X98,0X26,0X00,0X00,0X00,0X00,0X00,0X00,0X00,0X00,0X00,0X00,0X07,
0XFE,0X00,0X18,0X98,0X26,0X00,0X00,0X00,0X00,0X00,0X00,0X00,0X00,0X07,0XFC,0X07,
0XCE,0X00,0X10,0X88,0X26,0X00,0X00,0X00,0X00,0X00,0X00,0X00,0X00,0X07,0XFC,0X07,
0XCD,0X84,0XF8,0X98,0X26,0X00,0X00,0X00,0X00,0X00,0X00,0X00,0X00,0X07,0XFC,0X07,
0XCC,0X0C,0XC0,0XD9,0X26,0X00,0X00,0X00,0X00,0X00,0X00,0X00,0X00,0X06,0X6C,0X07,
0XFE,0X1F,0XC3,0XCF,0XE6,0X00,0X00,0X00,0X00,0X00,0X00,0X00,0X00,0X06,0X6C,0X07,
0XF3,0X4F,0X80,0XC0,0X06,0X00,0X00,0X00,0X00,0X00,0X00,0X00,0X00,0X06,0X6C,0X07,
0XF3,0XE7,0XC0,0XC0,0X06,0X00,0X00,0X00,0X00,0X00,0X00,0X00,0X00,0X06,0X6C,0X07,
0XFF,0XFF,0XFF,0XFF,0XFE,0X00,0X00,0X00,0X00,0X00,0X00,0X00,0X00,0X00,0X00,0X07,
0XFF,0XFF,0XFF,0XFF,0XFF,0XFF,0XFF,0XFF,0XFF,0XFF,0XFF,0XFF,0XFF,0XFF,0XFF,0XFF,
0XFF,0XFF,0XFF,0XFF,0XFF,0XFF,0XFF,0XFF,0XFF,0XFF,0XFF,0XFF,0XFF,0XFF,0XFF,0XFF,
0XFF,0XFF,0XFF,0XFF,0XFF,0XFF,0XFF,0XFF,0XFF,0XFF,0XFF,0XFF,0XFF,0XFF,0XFF,0XFF,
};
