sorell/whirling-electrons/test-arduino-er-erm029/Examples_ER-EPM029-1Y/ER-EPM029-1.h

/***************************************************
//Web: http://www.buydisplay.com
EastRising Technology Co.,LTD
****************************************************/

#ifndef EPD2IN9_H
#define EPD2IN9_H

#include "epdif.h"


#define EPD_WIDTH       128
#define EPD_HEIGHT      296


#define DRIVER_OUTPUT_CONTROL                       0x01
#define BOOSTER_SOFT_START_CONTROL                  0x0C
#define GATE_SCAN_START_POSITION                    0x0F
#define DEEP_SLEEP_MODE                             0x10
#define DATA_ENTRY_MODE_SETTING                     0x11
#define SW_RESET                                    0x12
#define TEMPERATURE_SENSOR_CONTROL                  0x1A
#define MASTER_ACTIVATION                           0x20
#define DISPLAY_UPDATE_CONTROL_1                    0x21
#define DISPLAY_UPDATE_CONTROL_2                    0x22
#define WRITE_RAM_BW                                0x24
#define WRITE_RAM_RED                               0x26
#define WRITE_VCOM_REGISTER                         0x2C
#define WRITE_LUT_REGISTER                          0x32
#define SET_DUMMY_LINE_PERIOD                       0x3A
#define SET_GATE_TIME                               0x3B
#define BORDER_WAVEFORM_CONTROL                     0x3C
#define SET_RAM_X_ADDRESS_START_END_POSITION        0x44
#define SET_RAM_Y_ADDRESS_START_END_POSITION        0x45
#define SET_RAM_X_ADDRESS_COUNTER                   0x4E
#define SET_RAM_Y_ADDRESS_COUNTER                   0x4F

extern const unsigned char lut[];


class Epd : EpdIf {
public:
    unsigned int width;
    unsigned int height;

    Epd();
    ~Epd();
    int  Init(void);
    void SendCommand(unsigned char command);
    void SendData(unsigned char data);
    void WaitUntilIdle(void);
    void Reset(void);
     void SetFrameMemoryBlack(
        const unsigned char* image_buffer,
        int x,
        int y,
        int image_width,
        int image_height
    ); 
      void SetFrameMemoryRed(
        const unsigned char* image_buffer,
        int x,
        int y,
        int image_width,
        int image_height
    );   
    void SetFrameMemory(const unsigned char* frame_buffer_black, const unsigned char* frame_buffer_red);
    void ClearFrameMemory(void);
    void DisplayFrame(void);
    void Sleep(void);

private:
    unsigned int reset_pin;
    unsigned int dc_pin;
    unsigned int cs_pin;
    unsigned int busy_pin;


    void SetMemoryArea(int x_start, int y_start, int x_end, int y_end);
    void SetMemoryPointer(int x, int y);
};

#endif 

/* END OF FILE */
