sorell/whirling-electrons/test-arduino-er-erm029/Examples_ER-EPM029-1Y/epdif.cpp

/***************************************************
//Web: http://www.buydisplay.com
EastRising Technology Co.,LTD
****************************************************/

#include "epdif.h"
#include <spi.h>

EpdIf::EpdIf() {
};

EpdIf::~EpdIf() {
};

void EpdIf::DigitalWrite(int pin, int value) {
    digitalWrite(pin, value);
}

int EpdIf::DigitalRead(int pin) {
    return digitalRead(pin);
}

void EpdIf::DelayMs(unsigned int delaytime) {
    delay(delaytime);
}

void EpdIf::SpiTransfer(unsigned char data) {
    digitalWrite(CS_PIN, LOW);
    SPI.transfer(data);
    digitalWrite(CS_PIN, HIGH);
}

int EpdIf::IfInit(void) {
    pinMode(CS_PIN, OUTPUT);
    pinMode(RST_PIN, OUTPUT);
    pinMode(DC_PIN, OUTPUT);
    pinMode(BUSY_PIN, INPUT); 
    SPI.beginTransaction(SPISettings(2000000, MSBFIRST, SPI_MODE0));
    SPI.begin();
    return 0;
}
