sorell/whirling-electrons/test-arduino-er-erm029/Examples_ER-EPM029-1Y/imagedata.h

/***************************************************
//Web: http://www.buydisplay.com
EastRising Technology Co.,LTD
****************************************************/

extern const unsigned char IMAGE_BLACK[];
extern const unsigned char IMAGE_YELLOW[];
extern const unsigned char IMAGE_BLACK1[];
extern const unsigned char IMAGE_YELLOW1[];

/* FILE END */
