sorell/whirling-electrons/(commit log)

2018-12-11 Arduino nano breakout 1. Infinity table arduino code.
    [arduino-nano-breakout-1.kicad_pcb, arduino-nano-breakout-1.sch]
2019-02-20 Add a few tea-timer project and a few READMEs.
2019-02-21 Tea timer pcb, datasheets
    [pcb-tea-timer.kicad_pcb, pcb-tea-timer.sch]
2019-02-21 Tea timer PCB finished.
    [arduino-nano-breakout-1.kicad_pcb, arduino-nano-breakout-1.sch, pcb-tea-timer.kicad_pcb, pcb-tea-timer.sch]
2019-02-23 Add button debounce filter.
    [pcb-tea-timer.kicad_pcb]
2019-03-15 Add bmp2arduino and implement picture drawing from data in tea-timer.ino
2019-03-21 Add images for tea timer
2019-03-22 Tea timer animations done. Fix bmp converter reading uneven rows.
2019-03-22 Remove converted image .c files in tea-timer: arduino seems to try to compile them.
2019-03-23 Pcb-tea-timer: fix piezo buzzer driving with a mosfet.
    [pcb-tea-timer.kicad_pcb, pcb-tea-timer.sch]
2019-03-24 Tea timer complete. Maybe to add more songs in the future..?
2019-03-24 Add motd to tea timer and fix bmp 4byte aligning in bmp2arduino.
2019-03-27 Tea-timer: first upButton sets the time to 2:30
2019-03-27 Tea-timer: add Amelie Waltz and Game of Thrones theme.
2019-03-28 Tea-timer: move songs to progmem.
2019-04-12 Tea-timer: fix some comments, remove amelie's intro, constify some code.
2019-04-12 Tea-timer: introduce song list. Implement fading texts.
2019-09-20 Add voltage-sense project. Still preliminary.
    [voltage-sense.kicad_pcb, voltage-sense.sch]
2019-09-20 Pcb-tea-timer: add capacitor to support vcc against drops
    [pcb-tea-timer.kicad_pcb, pcb-tea-timer.sch]
2019-10-23 Clarify directory naming
    [arduino-nano-breakout-1.kicad_pcb, arduino-nano-breakout-1.sch, pcb-tea-timer.kicad_pcb, pcb-tea-timer.sch, voltage-sense.kicad_pcb, voltage-sense.sch]
2019-12-06 Add advent calendar sw and schematic.
    [advent-calendar-rnd.kicad_pcb, advent-calendar-rnd.sch]
2020-11-07 Add parking-timer-pcb, with RDA5807M symbol and footprint.
    [parking-timer.kicad_pcb, parking-timer.sch]
2020-11-08 Printed FM antenna design, castellation footprint for RDA5807M, RF filter.
    [parking-timer.kicad_pcb, parking-timer.sch]
2020-11-13 Add parking-timer-sw with build system and one tiny test app
2020-11-13 Add display connector, STM8L101F3
    [parking-timer.kicad_pcb, parking-timer.sch]
2020-11-13 Purge gitignored files from parking-timer-pcb
2020-11-14 Parking-timer-pcb: footprint for ER-EPM029-1, LIS3DSH module. Rework placement.
    [parking-timer.kicad_pcb, parking-timer.sch]
2020-11-15 Parking-timer-pcb: add BatteryHolder footprint, move MCU.
    [parking-timer.kicad_pcb, parking-timer.sch]
2020-11-17 Parking-timer-pcb: Fix ER-EPM029 footprint holes, add ADS1220 and a bazillion of other layout changes.
    [parking-timer.kicad_pcb, parking-timer.sch]
2020-11-19 parking-timer-pcb: Add solar cell connection, update STM8L101F3 symbol and footprint from ST. Fix DRC errors.
    [parking-timer.kicad_pcb, parking-timer.sch]
2020-11-20 Parking-timer-pcg: Add debug GND pin. Add comments and reorganize a bit.
    [parking-timer.kicad_pcb, parking-timer.sch]
2021-03-21 Modify gitignore for Kicad completeness. Remove parking-timer-sw (and move to another repo: mcu-galore). Add Adruino test projects for ER-ERM029 and RDA5807m.
2022-03-23 Infinity-table-pcb v2
    Infinity table PCB with two buttons and a potentiometer.
    Placeholder for a txs0108 level shifter.
    [infinity-table-pcb.kicad_pcb, infinity-table-pcb.kicad_sch, infinity-table-pcb.sch]
2022-03-23 Infinity-table-pcb v2 ordered gerbers and drill files.
    [infinity-table-pcb-B_Cu.gbr, infinity-table-pcb-B_Mask.gbr, infinity-table-pcb-B_Paste.gbr, infinity-table-pcb-B_Silkscreen.gbr, infinity-table-pcb-Edge_Cuts.gbr, infinity-table-pcb-F_Cu.gbr, infinity-table-pcb-F_Mask.gbr, infinity-table-pcb-F_Paste.gbr]
2022-10-30 Stairway to heaven PCB
    [Fets.kicad_sch, ON_Semi_-_FDN337N.step, psu.kicad_sch, stairway-to-heaven-pcb.kicad_pcb, stairway-to-heaven-pcb.kicad_sch]
2022-10-30 Stairway to heaven gerbers. Ordered.
    [stairway-to-heaven-pcb-B_Cu.gbr, stairway-to-heaven-pcb-B_Mask.gbr, stairway-to-heaven-pcb-B_Paste.gbr, stairway-to-heaven-pcb-B_Silkscreen.gbr, stairway-to-heaven-pcb-Edge_Cuts.gbr, stairway-to-heaven-pcb-F_Cu.gbr, stairway-to-heaven-pcb-F_Mask.gbr, stairway-to-heaven-pcb-F_Paste.gbr]
2022-12-28 Add pdf prints for infinity-table, advent-calendar and stairway-to-heaven.
    [Fets.kicad_sch, advent-calendar-rnd.kicad_pcb, advent-calendar-rnd.kicad_sch, advent-calendar-rnd.sch, psu.kicad_sch, stairway-to-heaven-pcb.kicad_sch]
2026-10-07 tea-timer-sw: Fix garbaging animations
    Adafruit_GFX expects startWrite() before setAddrWindow().
    [tea-timer-sw.ino]
